balrog-kun/blinkenbike/diagram.png

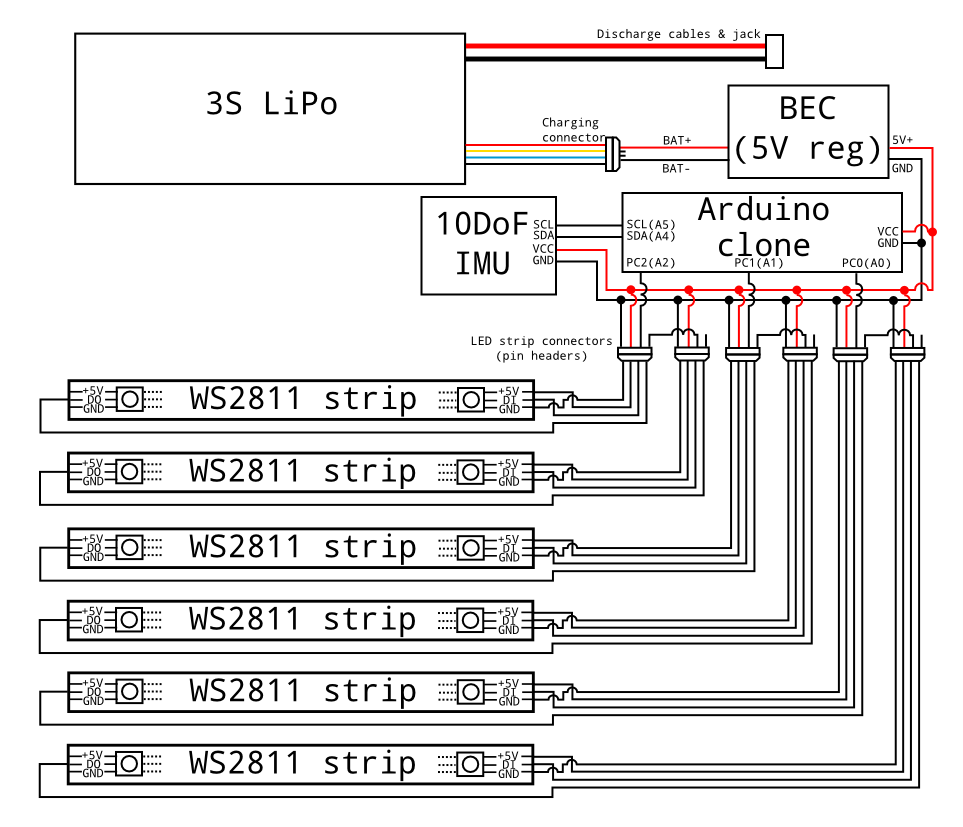
diagram.png
