balrog-kun/blinkenbike/wheel.ino

/*
 * Author: Andrew Zaborowski <andrew.zaborowski@intel.com>
 *
 * Licensed under the BSD license.
 */
#include <I2Cdev.h>
#include <MPU60X0.h>
#include <WS2811.h>

#include <Wire.h>
#include <SPI.h>

#include <math.h>
#include <avr/eeprom.h>
#include <avr/pgmspace.h>

#include "./Timers.h"

/* Sensors */
static MPU60X0 accgyro;
static int32_t gyro_offset[3];

static void zero_gyro(void) {
	int i;
	int reading[6];

	gyro_offset[0] = 0;
	gyro_offset[1] = 0;
	gyro_offset[2] = 0;

#define CALIB_SHIFT 7
	for (i = 0; i < (1 << CALIB_SHIFT); i ++) {
		accgyro.getMotion6(&reading[0], &reading[1], &reading[2],
				&reading[3], &reading[4], &reading[5]);

		gyro_offset[0] += reading[3];
		gyro_offset[1] += reading[4];
		gyro_offset[2] += reading[5];
		delay(1);
	}
}

/* Define the output function, using pin 2 on port C. */
#define LED_DDR  DDRC
#define LED_PORT PORTC
#define LED_PIN0 2
#define LED_PIN1 1
#define LED_PIN2 0
#ifdef SEQUENTIAL
DEFINE_WS2811_OUT_1_FN(ws2811_send_01, LED_PORT, LED_PIN0)
DEFINE_WS2811_OUT_1_FN(ws2811_send_23, LED_PORT, LED_PIN1)
DEFINE_WS2811_OUT_1_FN(ws2811_send_45, LED_PORT, LED_PIN2)
#else
DEFINE_WS2811_OUT_3_COMMON_FN(ws2811_send3, LED_PORT,
		LED_PIN0, LED_PIN1, LED_PIN2)
#endif

/* LED count and placement data */
static int led_cnt;
static uint16_t led_angle[128];
static uint8_t led_dist[128];
static uint8_t min_dist, full_dist;
struct led_strip_s {
	int x0, y0, x1, y1, count;
} strips[] = {
	/*
	 * Wheel is in a "zero" position, LED coordinates are in the wheel's
	 * plane, X being the horizontal axis (bike's forward-back), Y the
	 * vertical axis (bike's up-down), in milimeters.
	 * x0, y0 is the first LED in the strip,
	 * x1, y1 is the last LED, count is the number of LEDs including
	 * first and last.
	 */
	{
		-32, 48,
		-51, 282,
		15,
	},
	{
		32, 48,
		51, 282,
		15,
	},
	{
		58, 4,
		270, -97,
		15,
	},
	{
		25, -52,
		219, -185,
		15,
	},
	{
		-25, -52,
		-219, -185,
		15,
	},
	{
		-58, 4,
		-270, -97,
		15,
	},

	{ 0, 0, 0, 0, 0 }
};

/* Max. supported LED distance from wheel centre */
#define DIST_MAX 300.0f

/* Local static variables moved here so they can be saved / restored
 * to/from eeprom as a block */
static struct {
#define EEPROM_VER 1
#define EEPROM_MAGIC (0x00abcdef + EEPROM_VER)
	uint32_t magic;

	uint8_t prog;
	uint16_t gyro_mult;
	float cf_acc[2];
	uint8_t cf_samples;
} config, prev_config;

static uint8_t signal_cnt;
static RGB_t signal_rgb;

/*
 * Don't actually use this by default, seem to kill cheap arduino
 * clones left and right...
 */
//#define USE_EEPROM

static void eeprom_load(void) {
#ifdef USE_EEPROM
	eeprom_read_block(&config, NULL, sizeof(config));
#endif

	if (config.magic != EEPROM_MAGIC) {
		/* No saved config found, reset the config */
		config.magic = EEPROM_MAGIC;

		config.prog = 0;
		config.gyro_mult = 1 << 14;
		config.cf_acc[0] = 50.0f * 65536 * 16;
		config.cf_acc[1] = -150.0f * 65536 * 16;
		config.cf_samples = 0;
	}

	prev_config = config;
}

static void eeprom_save(void) {
#ifdef USE_EEPROM
	/* Check if there's any change */

#define DIFF(f) abs(config.f - prev_config.f)
#define DIFF_CHK(f) (abs(prev_config.f > 0.00001f) && \
		abs((config.f - prev_config.f) / prev_config.f) > 0.1f)

	if (!(/*DIFF_CHK(cf_acc[0]) || DIFF_CHK(cf_acc[1]) ||*/
			DIFF(gyro_mult) < 40))
		return;

	eeprom_write_block(&config, NULL, sizeof(config));

	prev_config = config;

	signal_cnt = 100;
	signal_rgb.r = 100;
	signal_rgb.g = 0;
	signal_rgb.b = 100;
#endif
}

#define DEGS_TO_ANGLE(x) (uint16_t) (x / 180.0f * (1uLL << 15))
#define DEG_PER_S_TO_RATE(x) (int16_t) (x * 16.4f)

extern int16_t acc[2];
extern uint16_t angle;

/* Forward decl for versions of Arduino that won't automatically do this */
static void acc_update(void);

void setup(void) {
	struct led_strip_s *s;
	int i;
	float x, y;

	/*
	 * Deactivate internal pull-ups for twi as per note from the
	 * atmega8 manual.
	 */
	PORTC &= ~((1 << 4) | (1 << 5));

	/* Switch to 400KHz I2C */
	TWBR = ((F_CPU / 400000L) - 16) / 2;

	accgyro = MPU60X0(false, MPU60X0_DEFAULT_ADDRESS);
	accgyro.initialize();
	accgyro.setI2CMasterModeEnabled(0);
	accgyro.setI2CBypassEnabled(1);
	accgyro.setFullScaleGyroRange(MPU60X0_GYRO_FS_2000);
	accgyro.setFullScaleAccelRange(MPU60X0_ACCEL_FS_8);
	delay(5);
	zero_gyro();

	/* Initialise LED stuff, precalculate angles */
	LED_DDR |= 1 << LED_PIN0;
	LED_DDR |= 1 << LED_PIN1;
	LED_DDR |= 1 << LED_PIN2;
	LED_PORT &= ~(1 << LED_PIN0);
	LED_PORT &= ~(1 << LED_PIN1);
	LED_PORT &= ~(1 << LED_PIN2);

	led_cnt = 0;
	for (s = &strips[0]; s->count; s ++) {
		for (i = 0; i < s->count; i ++) {
			x = s->x0 + (s->x1 - s->x0) * i /
				(float) (s->count - 1);
			y = s->y0 + (s->y1 - s->y0) * i /
				(float) (s->count - 1);

			led_dist[led_cnt] =
				sqrt((float) x * x + (float) y * y) /
				DIST_MAX * 127.0;
			led_angle[led_cnt] = 32768L - (uint16_t)
				((atan2(x, y) * (32768.0 / M_PI)));
			led_cnt ++;
		}
	}
	min_dist = led_dist[0];
	full_dist = led_dist[14] - led_dist[0];

	eeprom_load();

	/* Accelerometer-based rough initial angle */
	acc_update();
	angle = atan2(acc[0], acc[1]) * (-32768.0f / M_PI);

	/* Must re-init because Arduino init clobbers the Timers constructor */
	Timers::begin();

	Serial.begin(115200);
}

/*
 * Arduino seems to always use -Os but in this case we need speed.
 * Up to this point it's mostly setup functions and cold paths so
 * the default -Os is Ok.
 */
/*
 * The pragma doesn't work under g++ version that Arduino 1.5.4 uses:
 * https://gcc.gnu.org/bugzilla/show_bug.cgi?id=48026, try using
 * Arduino 1.5.6 or later, which uses a fixed GCC
 */
#pragma GCC optimize ("O3")
#define opts __attribute__((optimize("O3")))

#pragma GCC diagnostic error "-Wall"

/*
 * Max LED brightness to use.  255 is the absolute max value but it
 * seems that even 40 is more than enough at night even with some
 * ambient light.  During daylight a little more may be needed, but
 * at higher values there's less noticeable difference.  255 is probably
 * stronger than needed and very current hungry, generates heat too.
 */
#define LED_ON 100

/*
 * The functions below animate the LEDs in different ways
 * as the wheel turns.  Only one program is active at any
 * time.
 */

/* Illuminate one half of the wheel disc */
static void prog_half_set_leds(uint16_t zero_angle, RGB_t *rgb) opts;
static void prog_half_set_leds(uint16_t zero_angle, RGB_t *rgb) {
	for (uint8_t i = 0; i < led_cnt; i ++) {
		uint16_t angle = zero_angle - led_angle[i];

		rgb[i].r = angle > DEGS_TO_ANGLE(180.0f) ? LED_ON : 0;
		rgb[i].g = angle > DEGS_TO_ANGLE(180.0f) ? LED_ON : 0;
		rgb[i].b = angle > DEGS_TO_ANGLE(180.0f) ? LED_ON : 0;
	}
}

static void debug_red_set_leds(uint16_t zero_angle, RGB_t *rgb) {
	for (uint8_t i = 0; i < led_cnt; i ++) {
		uint16_t angle = zero_angle - led_angle[i];

		rgb[i].r = angle > DEGS_TO_ANGLE(180.0f) ? LED_ON : 0;
		rgb[i].g = 0;
		rgb[i].b = 0;
	}
}

static void debug_green_set_leds(uint16_t zero_angle, RGB_t *rgb) {
	for (uint8_t i = 0; i < led_cnt; i ++) {
		uint16_t angle = zero_angle - led_angle[i];

		rgb[i].g = angle > DEGS_TO_ANGLE(180.0f) ? LED_ON : 0;
		rgb[i].b = 0;
		rgb[i].r = 0;
	}
}

/* Text font data */
extern const uint8_t fontdata_8x8[];

/* Display hardcoded text */
static void prog_text12_set_leds(uint16_t zero_angle, RGB_t *rgb,
		const char *label) opts;
static void prog_text12_set_leds(uint16_t zero_angle, RGB_t *rgb,
		const char *label) {
	/*
	 * This is #if zeroed out because it's too slow for this particular
	 * use.  It's generic and nice because you can change the parameters
	 * relatively easily but it's also over 2x slower than the version
	 * with those same values hardcoded.  The atmega328 is quite slow
	 * at 16MHz, as an 8-bit mcu.  The version after #else is the same
	 * code with some basic optimisations, perhaps much more can be
	 * squeezed in.
	 */
#if 0
	static const int label_len = 12;
	static const uint16_t angle_len = DEGS_TO_ANGLE(180.0f);
	static const uint16_t maxangle = min((uint32_t) 65535,
		(uint32_t) angle_len * (65536uLL / (uint32_t) angle_len));
	static const int fontwidth = 8;
	static const int fontheight = 8;

	for (uint8_t i = 0; i < led_cnt; i ++) {
		uint16_t angle = zero_angle - led_angle[i];
		uint8_t val, chnum;

		if (angle >= maxangle) {
			val = 0;
		} else {
			uint16_t pxpos = (uint32_t) angle *
				(label_len * fontwidth) / angle_len;
			chnum = (pxpos / fontwidth) % label_len;
			uint8_t ch = label[chnum];
			uint8_t x = pxpos % fontwidth;
			uint8_t y = (uint16_t) 15 * (led_dist[i] - min_dist) /
				full_dist;

			val = (y < 15 - fontheight) ? 0 :
				((pgm_read_byte(&fontdata_8x8[(uint16_t) ch *
						fontheight + (15 - 1 - y)]) >>
				  (7 - x)) & 1);
		}

		rgb[i].r = val ? LED_ON : 0;
		rgb[i].g = (val && chnum) ? LED_ON : 0;
		rgb[i].b = (val && chnum) ? LED_ON : 0;
	}
#else
	static const int label_len = 12;
	static const int fontwidth = 8;
	static const int fontheight = 8;

	for (uint8_t i = 0, y = 0; i < led_cnt; i ++, y ++) {
		uint16_t angle = zero_angle - led_angle[i];

		/* For len == 12 could use two shifts and a sum... */
		/* Except shifts on AVR kinda suck too. */
		uint16_t pxpos = ((uint32_t) angle *
				(label_len * fontwidth)) >> 15;
		uint8_t x = pxpos & (fontwidth - 1);
		uint8_t chnum = pxpos >> 3;
		if (chnum >= 12)
			chnum -= 12;
		uint8_t ch = label[chnum];
		if (y == 15)
			y = 0;

		if (y >= 15 - fontheight &&
				((pgm_read_byte(&fontdata_8x8[(uint16_t) ch *
						fontheight + (15 - 1 - y)]) >>
				  (7 - x)) & 1)) {
			rgb[i].r = LED_ON;
			rgb[i].g = chnum ? LED_ON : 0;
			rgb[i].b = chnum ? LED_ON : 0;
		} else
			rgb[i] = (RGB_t) { 0, 0, 0 };
	}
#endif
}

static void prog_bicicritica_set_leds(uint16_t zero_angle, RGB_t *rgb) {
	prog_text12_set_leds(zero_angle, rgb, "Bicicritica ");
}

/*
 * Illuminate all LEDs with the colour set in signal_rgb to
 * signal some sort of event -- the colour tells the user what
 * happened.
 */
static void prog_signal_set_leds(uint16_t zero_angle, RGB_t *rgb) opts;
static void prog_signal_set_leds(uint16_t zero_angle, RGB_t *rgb) {
	for (uint8_t i = 0; i < led_cnt; i ++) {
		rgb[i].r = signal_rgb.r;
		rgb[i].g = signal_rgb.g;
		rgb[i].b = signal_rgb.b;
	}
}

/* All LEDs off */
static void prog_off_set_leds(uint16_t zero_angle, RGB_t *rgb) opts;
static void prog_off_set_leds(uint16_t zero_angle, RGB_t *rgb) {
	for (uint8_t i = 0; i < led_cnt; i ++) {
		rgb[i].r = 0;
		rgb[i].g = 0;
		rgb[i].b = 0;
	}
}

/* All LEDs full power */
static void prog_on_set_leds(uint16_t zero_angle, RGB_t *rgb) opts;
static void prog_on_set_leds(uint16_t zero_angle, RGB_t *rgb) {
	for (uint8_t i = 0; i < led_cnt; i ++) {
		rgb[i].r = LED_ON;
		rgb[i].g = LED_ON;
		rgb[i].b = LED_ON;
	}
}

/* Moving spiral shape */
static void prog_spiral_set_leds(uint16_t zero_angle, RGB_t *rgb) opts;
static void prog_spiral_set_leds(uint16_t zero_angle, RGB_t *rgb) {
	uint16_t millisx16 = Timers::now() >> 10;

	for (uint8_t i = 0; i < led_cnt; i ++) {
		uint16_t angle = zero_angle - led_angle[i];

		uint16_t pos = angle - millisx16 +
			((uint32_t) led_dist[i] << 17) / full_dist;

		uint8_t brightness = pos >> 6;
		uint8_t blue = pos >> 15;
		if (pos & (1 << 14))
			brightness ^= 255;

		/* Decrease "gamma", these LEDs are bright at low values */
		brightness -= min(brightness, (brightness ^ 255) / 3);

		rgb[i].r = blue ? 0 : brightness;
		rgb[i].g = blue ? 0 : brightness;
		rgb[i].b = brightness;
	}
}

/* Pacman image like in Adafruit's spokepov */
static void prog_pacman_set_leds(uint16_t zero_angle, RGB_t *rgb) opts;
static void prog_pacman_set_leds(uint16_t zero_angle, RGB_t *rgb) {
	uint16_t subsec = Timers::now() >> 19;
	uint8_t halfsec = subsec >> 4;
	bool open = halfsec & 1;

	if (open) {
		/* Pacman mouth open */
		for (uint8_t i = 0, x = 0; i < led_cnt; i ++, x ++) {
			uint16_t angle = zero_angle - led_angle[i];

			if (x == 15)
				x = 0;

			if (angle < DEGS_TO_ANGLE(230.0f) ||
					angle > DEGS_TO_ANGLE(310.0f)) {
				rgb[i].r = LED_ON;
				rgb[i].g = LED_ON;
				rgb[i].b = 0;
			} else {
				uint8_t dist = x - (15 - ((subsec + 8) & 15));
				uint16_t adist = 32768 / ((led_dist[i] >> 3) + 1);
				uint16_t y = angle -
					(DEGS_TO_ANGLE(270.0f) - adist);
				if (dist < 3 && y < adist) {
					rgb[i].r = LED_ON;
					rgb[i].g = LED_ON;
					rgb[i].b = LED_ON;
				} else {
					rgb[i].r = 0;
					rgb[i].g = 0;
					rgb[i].b = 0;
				}
			}
		}
	} else {
		/* Pacman mouth closed */
		for (uint8_t i = 0; i < led_cnt; i ++) {
#if 0
			rgb[i].r = LED_ON;
			rgb[i].g = LED_ON;
			rgb[i].b = 0;
#else
			uint16_t angle = zero_angle - led_angle[i];

			if (angle < DEGS_TO_ANGLE(262.0f) ||
					angle > DEGS_TO_ANGLE(278.0f)) {
				rgb[i].r = LED_ON;
				rgb[i].g = LED_ON;
				rgb[i].b = 0;
			} else {
				rgb[i].r = 0;
				rgb[i].g = 0;
				rgb[i].b = 0;
			}
#endif
		}
	}
}

/*
 * Rotating globe attempt
 *
 * Lots of tabularised trig here, all of it only valid for the current
 * set of LED positions.  Any change and all of this data needs to be
 * regenerated.
 */
extern const uint8_t a_d_to_lon_data[];
extern const uint8_t a_d_to_y_data[];
extern const uint8_t y_lon_to_land[];

static inline uint8_t a_d_to_lon(uint16_t angle, uint8_t dist) opts;
static inline uint8_t a_d_to_lon(uint16_t angle, uint8_t dist) {
	uint8_t a = angle >> 7;
	uint8_t ret;

	if (!a)
		return 0;
	if (a > 128)
		a = ~a;
	else
		a -= 1;
	ret = pgm_read_byte(&a_d_to_lon_data[a | ((uint16_t) dist << 7)]);

	return (angle >> 15) ? -ret : ret;
}

static inline uint8_t a_d_to_y(uint16_t angle, uint8_t dist) opts;
static inline uint8_t a_d_to_y(uint16_t angle, uint8_t dist) {
	uint8_t a = angle >> 7;
	uint8_t ret;

	if (a == 128)
		return 32;
	if (a > 128)
		a = -a;
	ret = pgm_read_byte(&a_d_to_y_data[a | ((uint16_t) dist << 7)]);

	return 32 + ((((angle >> 14) ^ (angle >> 15)) & 1) ? ret : -ret);
}

static void prog_globe_set_leds(uint16_t zero_angle, RGB_t *rgb) opts;
static void prog_globe_set_leds(uint16_t zero_angle, RGB_t *rgb) {
	uint8_t secsby64 = Timers::now() >> 18;

	for (uint8_t i = 0, d = 0; i < led_cnt; i ++, d ++) {
		uint16_t angle = zero_angle - led_angle[i];

		if (d == 15)
			d = 0;

		uint8_t lon = -secsby64 - a_d_to_lon(angle, d);
		uint8_t y = a_d_to_y(angle, d);

		uint16_t addr = ((uint16_t) y << 8) | lon;
		bool land = (pgm_read_byte(&y_lon_to_land[addr >> 3]) >>
				(addr & 7)) & 1;

		if (land) {
			if (y > 8) {
				/* Green land */
				rgb[i].r = LED_ON / 3;
				rgb[i].g = LED_ON;
				rgb[i].b = LED_ON / 5;
			} else {
				/* Antarctica */
				rgb[i].r = LED_ON;
				rgb[i].g = LED_ON;
				rgb[i].b = LED_ON;
			}
		} else {
			/* Dark blue ocean */
			rgb[i].r = 0;
			rgb[i].g = 0;
			rgb[i].b = LED_ON / 5;
		}
	}
}

static void (*progs_set_leds[])(uint16_t zero_angle, RGB_t *rgb) = {
	prog_half_set_leds,
	prog_bicicritica_set_leds,
	prog_off_set_leds,
	prog_on_set_leds,
	prog_spiral_set_leds,
	prog_pacman_set_leds,
	prog_globe_set_leds,
};
#define MAX_PROG ARRAYLEN(progs_set_leds)

#if F_CPU == 16000000
#define MICROS() (Timers::now() >> 4)
#elif F_CPU == 8000000
#define MICROS() (Timers::now() >> 3)
#else
#define MICROS() (Timers::now() / (F_CPU / 1000000))
#endif

/* Update gyro values and timestamps, used for gyro integration */
static int16_t gyro_reading;
static int32_t gyro_reading_mult;
static uint32_t now, timediff;
static void gyro_update(void) opts;
static void gyro_update(void) {
#define MULT_BITS 4
	gyro_reading_mult = (int32_t) accgyro.getRotationZ() << MULT_BITS;
	gyro_reading_mult -=
		(gyro_offset[2] +
		 (1 << (CALIB_SHIFT - MULT_BITS - 1))) >>
		(CALIB_SHIFT - MULT_BITS);
#ifndef REVERSE
	gyro_reading_mult = -gyro_reading_mult;
#endif
	gyro_reading = (gyro_reading_mult + (1 << (MULT_BITS - 1))) >>
		MULT_BITS;

	static uint32_t prev = 0;
	now = MICROS();
	timediff = now - prev;
	prev = now;
}

static int16_t acc_reading[3];
int16_t acc[2];
static int16_t cf_acc_int[2];
static void acc_update(void) opts;
static void acc_update(void) {
	accgyro.getAcceleration(acc_reading + 0,
			acc_reading + 1, acc_reading + 2);

	acc[0] = acc_reading[0];
	acc[1] = acc_reading[1];

	/*
	 * If cf calibration is based on reasonably many samples, use it for
	 * acc reading correction in gyro drift correction.
	 */
	if (config.cf_samples > 128) {
		uint16_t factor =
			((uint32_t) gyro_reading * gyro_reading) >> 20;
		acc[0] -= cf_acc_int[0] * factor;
		acc[1] -= cf_acc_int[1] * factor;
	}
}

uint16_t angle;
static uint16_t angle_update(void) opts;
static uint16_t angle_update(void) {
	int16_t step = ((int32_t) gyro_reading_mult * (int16_t) timediff) /
		(int32_t) (360.0f * 16.4f * 1000000.0f / 65536.0f + 0.499f);
	/*	            degs   lsb/deg    us/sec    lsb/360deg rounding */

	/* TODO: use optimised avr mult */
	step = ((int32_t) step * config.gyro_mult + (1 << (13 + MULT_BITS))) >>
		(14 + MULT_BITS);

	angle += step;

	/*
	 * Centrifugal force estimation.  We sum (acceleration vector /
	 * rotation rate ^ 2) over time -- at least a few full turns at a
	 * high enough rotation rate, to find the direction of the force
	 * and the relation to rotation rate.  This way, knowing the rotation
	 * rate at any later point, we can calculate the centrifugal force
	 * vector and subtract it from accelerometer readings in order to
	 * better approximate the gravity vector.
	 *
	 * The MPU6050 gyro has a max range of 2000deg/s and this is a slightly
	 * faster than we expect a bicycle wheel to be able to turn, so we
	 * assume a practical range of our centrifugal force calculations to be
	 * 90deg/s - 2000deg/s.  We set a lower limit too because the force is
	 * proportional to the square of rotation rate and below a given value
	 * the force should be negligible.
	 */
	static uint16_t angle_accum;
	static uint8_t iter_accum;
	static uint32_t time_prev;

	angle_accum += abs(step);
	iter_accum += 1;
	if (iter_accum > 100 || now - time_prev > 150000) {
		acc_update();

		uint32_t len = ((int32_t) acc[0] * acc[0]) +
			((int32_t) acc[1] * acc[1]);
		uint8_t correct = len > 0x1000000 / 2 && len < 0x1000000 * 2;

		uint16_t acc_angle = atan2(acc[0], acc[1]) *
			(-32768.0f / M_PI);
		int16_t err_angle = acc_angle - angle;

		/* Correct the current angle */
		if (correct)
			angle += (err_angle + 4) >> 3;

		/* Correct the gyro zero offset (angle integral) */
#ifdef REVERSE
		err_angle = -err_angle;
#endif
		if (correct)
			gyro_offset[2] +=
				((int32_t) err_angle << 2) / iter_accum;

#if 0
		uint16_t tdiff = (now - time_prev) / 1000;
		Serial.print((uint32_t) 1000 * iter_accum / tdiff);
		Serial.write("fps\r\n");
#endif
		time_prev = now;
		iter_accum = 0;

		if (angle_accum > DEGS_TO_ANGLE(30.0f) &&
				abs(gyro_reading) > DEG_PER_S_TO_RATE(70.0f)) {
			/*
			 * Quite literally what is described in comment above.
			 * Use floats so we don't have to worry about ranges.
			 * Since this is only done every now and then, the
			 * overhead should be fine.
			 * TODO: increase the sample weight with rotation rate?
			 */
			config.cf_acc[0] += (acc_reading[0] /
					((float) gyro_reading * gyro_reading) -
					config.cf_acc[0]) * 0.01f;
			config.cf_acc[1] += (acc_reading[1] /
					((float) gyro_reading * gyro_reading) -
					config.cf_acc[1]) * 0.01f;
			if (config.cf_samples < 255)
				config.cf_samples += 1;

			cf_acc_int[0] = config.cf_acc[0] * (65536.0f * 16.0f);
			cf_acc_int[1] = config.cf_acc[1] * (65536.0f * 16.0f);

			/*
			 * TODO: add phase shift between the cf calibration
			 * and acc-based gyro drift correction.
			 */

			/*
			 * Update gyro rate multiplier, use 1/32 weight (the
			 * 14-bit shift is reduced by 5 bits).
			 * TODO: decrease weight with rotation rate?
			 * TODO: rounding?
			 */
			static uint16_t prev_acc_angle = 0;
			static uint16_t prev_gyro_angle = 0;

			int16_t gyro_velo = prev_gyro_angle - angle;
			int16_t acc_velo = prev_acc_angle - acc_angle;
			prev_gyro_angle = angle;
			prev_acc_angle = acc_angle;

			if (correct && !(((uint16_t) acc_velo ^ gyro_velo) &
						0x8000) &&
					angle_accum < DEGS_TO_ANGLE(150.0f))
				config.gyro_mult += (((int32_t) abs(acc_velo) -
							abs(gyro_velo)) <<
						(14 - 7)) / angle_accum;

			if (config.gyro_mult < 0x2000)
				config.gyro_mult = 0x2000;
			if (config.gyro_mult > 0xc000)
				config.gyro_mult = 0xc000;

			eeprom_save();
			angle_accum = 0;
		}
	}

	return angle;
}

static void (*prog_set_leds)(uint16_t zero_angle, RGB_t *rgb);
static void prog_update(void) opts;
static void prog_update(void) {
	static uint8_t brakes = 0, braking = 0;
	static uint16_t brake_millis = 0;
	static int16_t prev_gyro = 0, brake_gyro = 0;
	static int32_t gyro_diff_lpf = 0;
	static int32_t gyro_diff_llpf = 0;

	uint8_t now_braking = 0;

	static uint16_t prev_millis = 0;

	uint16_t now_millis = now >> 10;
	uint16_t timediff = now_millis - prev_millis;
	prev_millis = now_millis;

	int16_t gyro_diff = gyro_reading - prev_gyro;
	prev_gyro = gyro_reading;
#define LPF_SCALE 8
	gyro_diff_lpf += (((int32_t) gyro_diff << LPF_SCALE) -
			gyro_diff_lpf + 8) >> 4;
	gyro_diff_llpf += (((int32_t) gyro_diff << LPF_SCALE) -
			gyro_diff_llpf + 512) >> 10;

	/* Are we braking?  For now use hardcoded values + some deadband */
	if (gyro_diff_lpf < gyro_diff_llpf - (25 << LPF_SCALE))
		now_braking = 1;
	else if (gyro_diff_lpf > gyro_diff_llpf - (2 << LPF_SCALE))
		now_braking = 0;
	else
		now_braking = braking;

	if (now_braking != braking) {
		uint16_t millis_since;

		millis_since = now_millis - brake_millis;
		brake_millis = now_millis;

		if (millis_since > braking ? 100 : 200 && millis_since < 400 &&
				(brakes != 0 || braking)) {
			brakes += 1;
		} else {
			/*
			 * If we've detected exactly two braking periods of
			 * given length (100-400ms) separated by periods of
			 * the similar length and then a 1 - 3s of no braking,
			 * switch to the next program.  If there were three
			 * breaks, switch one program back.
			 */
			if (millis_since > 1000 && millis_since < 3000 &&
					(brakes == 3 || brakes == 5)) {
				if (brakes == 3) {
					config.prog += 1;
					if (config.prog >= MAX_PROG)
						config.prog = 0;
				} else {
					config.prog -= 1;
					if ((int8_t) config.prog < 0)
						config.prog = MAX_PROG - 1;
				}
			}
			brakes = 0;
		}
		braking = now_braking;
	}

	/* TODO: define LPF scale like above, compare Z against X/Y */
	int16_t accz = accgyro.getAccelerationZ();
	static int32_t accz_lpf = 0;
	uint8_t tap = ((int32_t) accz << 4) > accz_lpf + (3000LL << 4);
	static uint8_t prev_tap = 0;
	static uint16_t tap_millis = 0;
	static uint8_t tap_seq = 0;

	accz_lpf += (((int32_t) accz << 4) - accz_lpf + 8) >> 4;

	if (tap && !prev_tap) {
		uint16_t millis_since;

		/* TODO: comment */
		millis_since = now_millis - tap_millis;
		if (millis_since > 40)
			tap_millis = now_millis;

		if (millis_since > 200 && millis_since < 400) {
			tap_seq += 1;
		} else if (millis_since > 40) {
			/*
			 * If we've detected three or four taps 200-400ms
			 * apart and another one after 1s-3s switch to
			 * the next or the previous program.
			 */
			if (millis_since > 1000 && millis_since < 3000 &&
					(tap_seq == 2 || tap_seq == 3)) {
				if (brakes == 2) {
					config.prog += 1;
					if (config.prog >= MAX_PROG)
						config.prog = 0;
				} else {
					config.prog -= 1;
					if ((int8_t) config.prog < 0)
						config.prog = MAX_PROG - 1;
				}
			}
			tap_seq = 0;
		}
	}
	prev_tap = tap;

#if 0
	static uint8_t tapcnt = 0;
	if (tap)
		tapcnt = 200;
	if (tapcnt > 0) {
		tapcnt --;
		prog_set_leds = debug_green_set_leds;
		return;
	} else if (now_braking) {
		prog_set_leds = debug_red_set_leds;
		return;
	}
#endif

	if (signal_cnt) {
		signal_cnt --;
		prog_set_leds = prog_signal_set_leds;
		return;
	}

	prog_set_leds = progs_set_leds[config.prog];

	/* Stop displaying the text label if spinning too slow or backwards */
	if (prog_set_leds == prog_bicicritica_set_leds &&
			gyro_reading < DEG_PER_S_TO_RATE(400.0))
		prog_set_leds = prog_half_set_leds;

	/* TODO: draw reverse if spinnig backwards? */
}

void loop(void) opts;
void loop(void) {
	gyro_update();
	angle_update();
	prog_update();

	RGB_t ledsrgb[128];
	prog_set_leds(angle, ledsrgb);
#ifdef SEQUENTIAL
	ws2811_send_01(ledsrgb +  0, 30);
	ws2811_send_23(ledsrgb + 30, 30);
	ws2811_send_45(ledsrgb + 60, 30);
#else
	ws2811_send3(ledsrgb + 0, ledsrgb + 30, ledsrgb + 60, 30);
#endif
}
