balrog-kun/blinkenbike/earth.ino

#include <avr/pgmspace.h>
const uint8_t a_d_to_lon_data[] PROGMEM = {
	0,
	0,
	0,
	0,
	1,
	1,
	1,
	1,
	1,
	1,
	1,
	1,
	1,
	1,
	2,
	2,
	2,
	2,
	2,
	2,
	2,
	2,
	2,
	2,
	3,
	3,
	3,
	3,
	3,
	3,
	3,
	3,
	3,
	3,
	3,
	4,
	4,
	4,
	4,
	4,
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
};
const uint8_t a_d_to_y_data[] PROGMEM = {
	6,
	6,
	6,
	6,
	6,
	6,
	6,
	6,
	6,
	6,
	6,
	6,
	6,
	6,
	6,
	6,
	6,
	6,
	6,
	6,
	6,
	6,
	6,
	6,
	6,
	6,
	6,
	6,
	6,
	6,
	6,
	6,
	6,
	6,
	6,
	6,
	6,
	6,
	6,
	6,
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
};
const uint8_t y_lon_to_land[] PROGMEM = {
	255,
	255,
	255,
	255,
	255,
	255,
	255,
	255,
	255,
	255,
	255,
	255,
	255,
	255,
	255,
	255,
	255,
	255,
	255,
	255,
	255,
	255,
	255,
	255,
	255,
	255,
	255,
	255,
	255,
	255,
	255,
	255,
	0,
	0,
	0,
	224,
	255,
	255,
	255,
	255,
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
};
