balrog-kun/blinkenbike/(commit log)

2014-06-25 Minimum functional code dump so I can bisect if I screw up.
2014-06-26 Detect bike braking for program mode switching.
2014-06-27 Use max LED brightness in the half-wheel prog.
2014-06-27 More careful gyro drift correction, still in testing.
    [wheel.ino]
2014-07-05 255 seems to give little added brightness over 100 or 128 but much highger current consumption. So it makes sense to use a lower default value and use 255 perhaps only riding in plain daylight. TODO: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
2014-07-05 Fix the direction of a less than operator.
    [wheel.ino]
2014-07-05 Better gyro speed runtime calibration, decrease correction rates.
    Now compares the rotation rate given by the gyro against that calculated
    naively from the accelerometer readings, not relying on the gyro
    zero position and the current angle to be correct. Also slash all
    three correction factors by 2 as the calibration should now work much
    better and not be needed that much after the initial catch-up. This
    will decrease later effects of braking etc. on the gyro-based angle.
    Also change the gyro rate factor default, for some reason the documented
    value seems to have been about half of what's really needed.
    [wheel.ino]
2014-07-17 Arduino micros() is unreliable, replace with our own timer API.
    This fixes a source of a problem that blocked the development for a
    while. Possibly due to the interrupts being disabled inside the
    WS2811 output function or for some other reason micros() was
    returning veyr unreliable results, lower than expected and I had
    been looking for the cause of the calculations coming out wrong
    pretty much everywhere except in the stock timer functions. At about
    300 iterations per second, micros() returned about half the real
    value, and closer to 50 fps it was approaching 0.9 of the actual
    value. The values were a little random too, jumping up and down
    about 5%.
    [Timers.cpp, Timers.h, wheel.ino]
2014-07-17 Fix the text display and use a slightly optimised version.
    Still pretty slow :( About 231 fps, ideal would be about 800.
    [wheel.ino]
2014-07-17 Spread the gyro calibration readings in time a little.
    The calibration doesn't really matter much with the MPU6050, this gyro
    seem to have a pretty stable zero value that could be hardcoded.
    [wheel.ino]
2014-07-17 Rough initial angle calculation from accelerometer.
2014-07-17 Casts to allow more flexible timing, better fixed-point rounding.
    [wheel.ino]
2014-07-17 Configure the accelerometer for +/-8g range, instead of 2.
2014-07-17 Online calibration time trigger (at most every 150ms).
2014-07-17 Reduce gyro zero rate online calibration factor.
    Seems the calibration gives little benefit now that the gyro integration
    works better.
2014-07-17 Read time once in gyro_update.
2014-07-17 Use a LUT instead of a big switch for led programs.
2014-07-21 Higher-res gyro readings to reduce rounding errors.
    Doesn't actually seem to help much but also doesn't cost much so
    stay with the higher precision version.
    [wheel.ino]
2014-07-21 Use 3 pins to drive 30 LEDs each, clock out pixels in parallel.
    Instead of having to clock out 90 values through one pin for 2.7ms, use
    3 pins (PC0, PC1, PC2 or Analog 1, 2, 3) each connected to two 15-LED
    strips, so we can simultanouesly output to 3 streams of values and only
    need 0.9ms.
    The half-wheel program now gets 677 fps instead of 303, the text program
    397 instead of 231 fps.
2014-07-27 Add the wiring diagram to the repo.
2014-07-27 Fix gyro_offset type to prevent overflow.
    [wheel.ino]
2014-07-27 Avoid millis() in spiral demo, reorder code.
    [wheel.ino]
2014-07-27 Adjust filter parameters a bit, fix REVERSE.
    It looks like the gyro_mult functionality is causing problems, for now
    use a lower weight and give a bigger weight to simple angle correction.
    Gives a pretty good result after some time of riding, i.e. probably when
    the centrifugal force estimation has enough data.
    [wheel.ino]
2014-07-27 1st attempt at an adafruit-like pacman demo.
    Probably needs some fixing to look good, like not closing the "mouth"
    completely.
    [wheel.ino]
2014-07-29 Try a better brake detection logic.
    First of all fix the "low pass filter" to be same scale as the variable
    and then shift left by 4 bits to add some precision. Secondly only
    compare its value against another LPF (an even slower one) to detect
    momentary braking vs. just slowing down. We still use absolute values
    in the comparison, may want to make them depend on the recent
    variability (std deviation) or perhaps make the min detectable brake
    period depend on that. We also still need to take timediff into account.
    Update README.
    [wheel.ino]
2014-09-27 Fix typo in variable name that had funny consequences.
    [wheel.ino]
2014-09-27 Don't shut pacman mouth completely.
    We should just add more frames in the animation but for now this will
    do.
2014-09-27 Relax the brake detection, still isn't so great...
2017-08-15 Add an extra forward declaration for Arduino 1.8.2
    Apparently the mechanism that existed in older versions that added
    forward function declarations doesn't catch our acc_update() function,
    maybe because of the opts macro usage, so add a normal forward
    declaration.
    [wheel.ino]
